BypassCapacitor/G431_S_V1/README.md

# G431_S_V1
STM32G431C8T6 system board, temporarily designed for the 2024 Electronic Design Competition.

Bug_0722:
1. Package_error

  The pins 1 and 2 of the transistor package have an unknown error on the actual PCB, requiring the transistor to be soldered upside down.
