BypassCapacitor/G431_S_V1/stm32g431c8t6.ioc

Mcu.UserName=STM32G431C8Tx
PA0.Signal=ADC1_IN1
PA1.Signal=ADC1_IN2
PA10.Signal=USART1_RX
PA13.Signal=SYS_JTMS-SWDIO
PA14.Signal=SYS_JTCK-SWCLK
PA15.Signal=I2C1_SCL
PA4.Signal=COMP_DAC11_group
PA5.Signal=COMP_DAC12_group
PA9.Signal=USART1_TX
PB11.Signal=GPIO_Input
PB12.Signal=GPIO_Input
PB13.Signal=GPIO_Input
PB14.Signal=GPIO_Input
PB15.Signal=GPIO_Output
PB7.Signal=I2C1_SDA
PF0-OSC_IN.Signal=RCC_OSC_IN
PF1-OSC_OUT.Signal=RCC_OSC_OUT
